Sommema4/Nicoll_GT/GME_nákup.pdf

Určení | Kód | Množství Cena za kus | Cena
GPTS203211B | 630-028 | 1 | 12 | 12
1N4007 | 220-002 popřpadě 917-065 | 5 | 1.6 | 8
1N5819 | 223-001 | 5 | 2.8 | 14
Barrel_Jack | 806-312 | 2 | 6.3 | 12.6
HE721A0510 | 634-012 | 2 | 27 | 54
BC547 | 210-026 | 5 | 1.7 | 8.5
1M | 901-036 | 5 | 0.68 | 3.4
10k | 901-003 | 10 | 0.68 | 6.8
1k | 901-029 | 5 | 0.68 | 3.4
2k | 901-066 | 5 | 0.68 | 3.4
5k | 901-128 | 5 | 0.68 | 3.4
470k | 901-110 | 5 | 0.68 | 3.4
Adaptér 9V | 751-811 | 1 | 139 | 139
Akumulátor | 540-492 | 1 | 159 | 159
Držák baterie 9V | 819-117 | 2 | 12 | 24
Napájecí konektor 9V 819-089 | 2 | 6.6 | 13.2
Patice PDIP-8 | 823-011 | 5 | 1.7 | 8.5
| | | | 476.6
