Sommema4/Nicoll_GT/Gerdien_tube_calculations.xlsx

Sheet: List1
Required properties |  |  | Comments | Constants
Min. sensitivity [ions/cm3] | 5 |  |  | 1 Coulomb [e-] | 1.602e+19
Temporal resolution [s] | 30
Fixed properties |  |  |  | Aux. calculations
ADC resolution [bits] | 12 |  | LoPy 4.0 | Min. detectable voltage [V] | 0.0029296875
Op-amp range [V] | 12 |  |  | SNR [-] | 3
Op-amp bias current [fA] | 5 |  |  | Min. ion current negative [fA] | 20
Outter electrode diameter [mm] | 15 |  |  | Min. ion current positive [fA] | 10
Inner electrode diameter [mm] | 3 |  |  | Min. negative ions charge [pC] | 0.6
Length of inner electrode [mm] | 150 |  |  | Min. positive ions charge [pC] | 0.3
 |  |  |  | Max. bias charge [pC] | 0.15
Computed properties
Capacity [pF] | 2
Flow [cm3/s] | 32040
Flow [m3/h] | 115.34
Flow [CFM] | 67.89 |  | https://cz.mouser.com/datasheet/2/471/San_Ace_60GV38_E-1286225.pdf
UAV speed [m/s] | 47.24
VD - dissipation [V][bits] | 0.075 | 25.6
VD - negative ion [V][bits] | 0.3 | 102.4
VD - positive ion [V][bits] | 0.15 | 51.2
Estimated fan power [W] | 23.76112032
dust sensor | sn-gcja5

Sheet: Sheet1
Year | Value |  | Divident value |  | Annual deposit | Budget | Divident
0 | 400000 | 0 | 16000 |  | 60000 | 400000 | 0.04 | 1000
1 | 476000 | 60000 | 19040 |  |  |  |  | 1030
2 | 555040 | 60000 | 22201.6 |  |  |  |  | 1060.9
3 | 637241.6 | 60000 | 25489.664 |  |  |  |  | 1092.727
4 | 722731.264 | 60000 | 28909.25056 |  |  |  |  | 1125.50881
5 | 811640.5146 | 60000 | 32465.62058 |  |  |  |  | 1159.274074
6 | 904106.1351 | 60000 | 36164.24541 |  |  |  |  | 1194.052297
7 | 1000270.381 | 60000 | 40010.81522 |  |  |  |  | 1229.873865
8 | 1100281.196 | 60000 | 44011.24783 |  |  |  |  | 1266.770081
9 | 1204292.444 | 60000 | 48171.69774 |  |  |  |  | 1304.773184
10 | 1312464.141 | 60000 | 52498.56565 |  |  |  |  | 1343.916379
11 | 1424962.707 | 60000 | 56998.50828 |  |  |  |  | 1384.233871
12 | 1541961.215 | 60000 | 61678.44861 |  |  |  |  | 1425.760887
13 | 1663639.664 | 60000 | 66545.58656 |  |  |  |  | 1468.533713
14 | 1790185.25 | 60000 | 71607.41002 |  |  |  |  | 1512.589725
15 | 1921792.66 | 60000 | 76871.70642 |  |  |  |  | 1557.967417
16 | 2058664.367 | 60000 | 82346.57468 |  |  |  |  | 1604.706439
17 | 2201010.942 | 60000 | 88040.43766 |  |  |  |  | 1652.847632
18 | 2349051.379 | 60000 | 93962.05517 |  |  |  |  | 1702.433061
19 | 2503013.434 | 60000 | 100120.5374 |  |  |  |  | 1753.506053
20 | 2663133.972 | 60000 | 106525.3589 | Added value |  |  |  | 1806.111235
 |  | 1200000 | 1169659.331 | 1063133.972
 |  | 0.6007959107 | 0.3992040893
