Sommema4/Nicoll_GT/Gerdien_tube.xlsx

Sheet: Gerdien_tube
Určovatel | Pouzdro | Množství | Určení | Dostupné | Cena za kus | Cena
S1 | PushButton_Round_D12mm_THT_KS-01Q-01 | 1 | GPTS203211B | 630-028 | 12 | 12
MH1,MH2,MH3,MH4 | MountingHole_3.2mm_M3_Pad | 4 | MountingHole_Pad |  |  | 0
A1 | Arduino_Nano | 1 | Arduino_Nano_v3.x |  |  | 0
C1,C3,C4,C6,C8 | C_1206_3216Metric_Pad1.42x1.75mm_HandSolder | 5 | 10uF | https://cz.mouser.com/ProductDetail/KEMET/C1206C106K4PACTU?qs=nz7vn1PXJ%2Feyzlyip0aTxw%3D%3D | 5.62 | 28.1
C2,C7,C10,C11 | C_0805_2012Metric_Pad1.15x1.40mm_HandSolder | 4 | 1uF | https://cz.mouser.com/ProductDetail/Taiyo-Yuden/EMK212B7105KG-T?qs=I6KAKw0tg2yMLHYVqC1Cbg%3D%3D | 3.04 | 12.16
C5 | C_0805_2012Metric_Pad1.15x1.40mm_HandSolder | 1 | 0.1uF | https://cz.mouser.com/ProductDetail/Wurth-Elektronik/885012207045?qs=0KOYDY2FL2%252BXQfJ0lEk3cQ%3D%3D | 2.08 | 2.08
C9 | C_1206_3216Metric_Pad1.42x1.75mm_HandSolder | 1 | 22uF | https://cz.mouser.com/ProductDetail/Taiyo-Yuden/EMK316ABJ226KL-T?qs=vRDgv%252B14ozAnLVgeVXAjKA%3D%3D | 11.7 | 11.7
D1,D3 | D_DO-41_SOD81_P10.16mm_Horizontal | 2 | 1N4007 | 220-002 popřpadě 917-065 | 1.6 | 3.2
D2 | D_DO-41_SOD81_P10.16mm_Horizontal | 1 | 1N5819 | 223-001 | 2.8 | 2.8
IC1 | SOIC127P600X175-8N | 1 | LMC6042IN/NOPB | https://cz.mouser.com/ProductDetail/Texas-Instruments/LMC6042IN-NOPB?qs=QbsRYf82W3F%252BvJ4QFsi9pA%3D%3D | 79.82 | 79.82
IC2 | SOP65P490X110-8N | 1 | CAT5140ZI-00-GT3 | https://cz.mouser.com/ProductDetail/ON-Semiconductor/CAT5140ZI-00-GT3 | 55.64 | 55.64
J1 | PinSocket_2x08_P2.54mm_Vertical | 1 | Conn_02x08_Odd_Even |  |  | 0
J2,J3 | PinSocket_1x06_P2.54mm_Vertical | 2 | Conn_01x06_Female |  |  | 0
J4 | PinHeader_1x03_P2.54mm_Vertical | 1 | Conn_01x03_Male |  |  | 0
J6,J7 | PinSocket_1x01_P2.54mm_Vertical | 2 | Conn_01x01_Female |  |  | 0
J8 | BarrelJack_Horizontal | 1 | Barrel_Jack | 806-312 | 6.3 | 6.3
J9,J10 | PinHeader_1x02_P2.54mm_Horizontal | 2 | Conn_01x02_Male |  |  | 0
K1,K2 | HE721A0510 | 2 | HE721A0510 | 634-012 | 27 | 54
MH5,MH6,MH7 | MountingHole_2.5mm | 3 | MountingHole |  |  | 0
PS1,PS2 | RP0512D | 2 | RH-0515D | https://cz.mouser.com/ProductDetail/RECOM-Power/RH-0515D?qs=YWgezujkI1I0O2RytZapjw%3D%3D | 171.34 | 342.68
Q1 | SOT-23-3 | 1 | BSS138 | https://cz.mouser.com/ProductDetail/ON-Semiconductor-Fairchild/BSS138?qs=HK%252BeIG1iaahCeqBvjB4arg%3D%3D | 6.08 | 6.08
Q2,Q5 | TO-92_Inline | 2 | BC547 | 210-026 | 1.7 | 3.4
Q3 | SOT95P237X112-3N | 1 | FDN306P | https://cz.mouser.com/ProductDetail/ON-Semiconductor-Fairchild/FDN306P | 10.53 | 10.53
Q4 | SOT-23-6 | 1 | LTC4412ES6_TRMPBF | https://cz.mouser.com/ProductDetail/Analog-Devices-Linear-Technology/LTC4412ES6TRMPBF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 | 80.6 | 80.6
R1,R3 | R_0805_2012Metric_Pad1.15x1.40mm_HandSolder | 2 | 1M | 901-036 | 0.68 | 1.36
R2,R4,R6,R13,R14 | R_0805_2012Metric_Pad1.15x1.40mm_HandSolder | 5 | 10k | 901-003 | 0.68 | 3.4
R5,R9,R16 | R_0805_2012Metric_Pad1.15x1.40mm_HandSolder | 3 | 1k | 901-029 | 0.68 | 2.04
R10 | R_0805_2012Metric_Pad1.15x1.40mm_HandSolder | 1 | 2k | 901-066 | 0.68 | 0.68
R11,R12 | R_0805_2012Metric_Pad1.15x1.40mm_HandSolder | 2 | 5k | 901-128 | 0.68 | 1.36
TP1,TP2 | PinHeader_1x01_P2.54mm_Vertical | 2 | TestPoint |  |  | 0
U1 | TEC3_0911 | 1 | TEC_3-0911 | https://cz.mouser.com/ProductDetail/TRACO-Power/TEC-3-0911?qs=55YtniHzbhAODAHTZEB25A%3D%3D | 281.32 | 281.32
G*** | CRREAT_197x129 | 1 | LOGO |  |  | 0
J11 | PinHeader_1x02_P2.54mm_Vertical | 1 | Conn_01x02_Male |  |  | 0
J5 | TerminalBlock_RND_205-00278_1x04_P5.00mm_Vertical | 1 | Screw_Terminal_01x04 |  |  | 0
R15 | R_0805_2012Metric_Pad1.15x1.40mm_HandSolder | 1 | 470k | 901-110 | 0.68 | 0.68
 | Adaptér | 1 |  | 751-811 | 139 | 139
 | Akumulátor | 1 |  | 540-492 | 159 | 159
 | Držák baterie | 1 |  | 819-117 | 12 | 12
 | Držák baterie | 1 |  | 819-089 | 6.6 | 6.6
 | patice | 1 |  | 823-011 | 1.7 | 1.7
 |  |  |  |  |  | 1320.23

Sheet: GME
Určení | Kód | Množství | Cena za kus | Cena
GPTS203211B | 630-028 | 1 | 12 | 12
1N4007 | 220-002 popřpadě 917-065 | 5 | 1.6 | 8
1N5819 | 223-001 | 5 | 2.8 | 14
Barrel_Jack | 806-312 | 2 | 6.3 | 12.6
HE721A0510 | 634-012 | 2 | 27 | 54
BC547 | 210-026 | 5 | 1.7 | 8.5
1M | 901-036 | 5 | 0.68 | 3.4
10k | 901-003 | 10 | 0.68 | 6.8
1k | 901-029 | 5 | 0.68 | 3.4
2k | 901-066 | 5 | 0.68 | 3.4
5k | 901-128 | 5 | 0.68 | 3.4
470k | 901-110 | 5 | 0.68 | 3.4
Adaptér 9V | 751-811 | 1 | 139 | 139
Akumulátor | 540-492 | 1 | 159 | 159
Držák baterie 9V | 819-117 | 2 | 12 | 24
Napájecí konektor 9V | 819-089 | 2 | 6.6 | 13.2
Patice PDIP-8 | 823-011 | 5 | 1.7 | 8.5
 |  |  |  | 476.6
