Sommema4/Nicoll_GT/Gerdien_tube.pdf

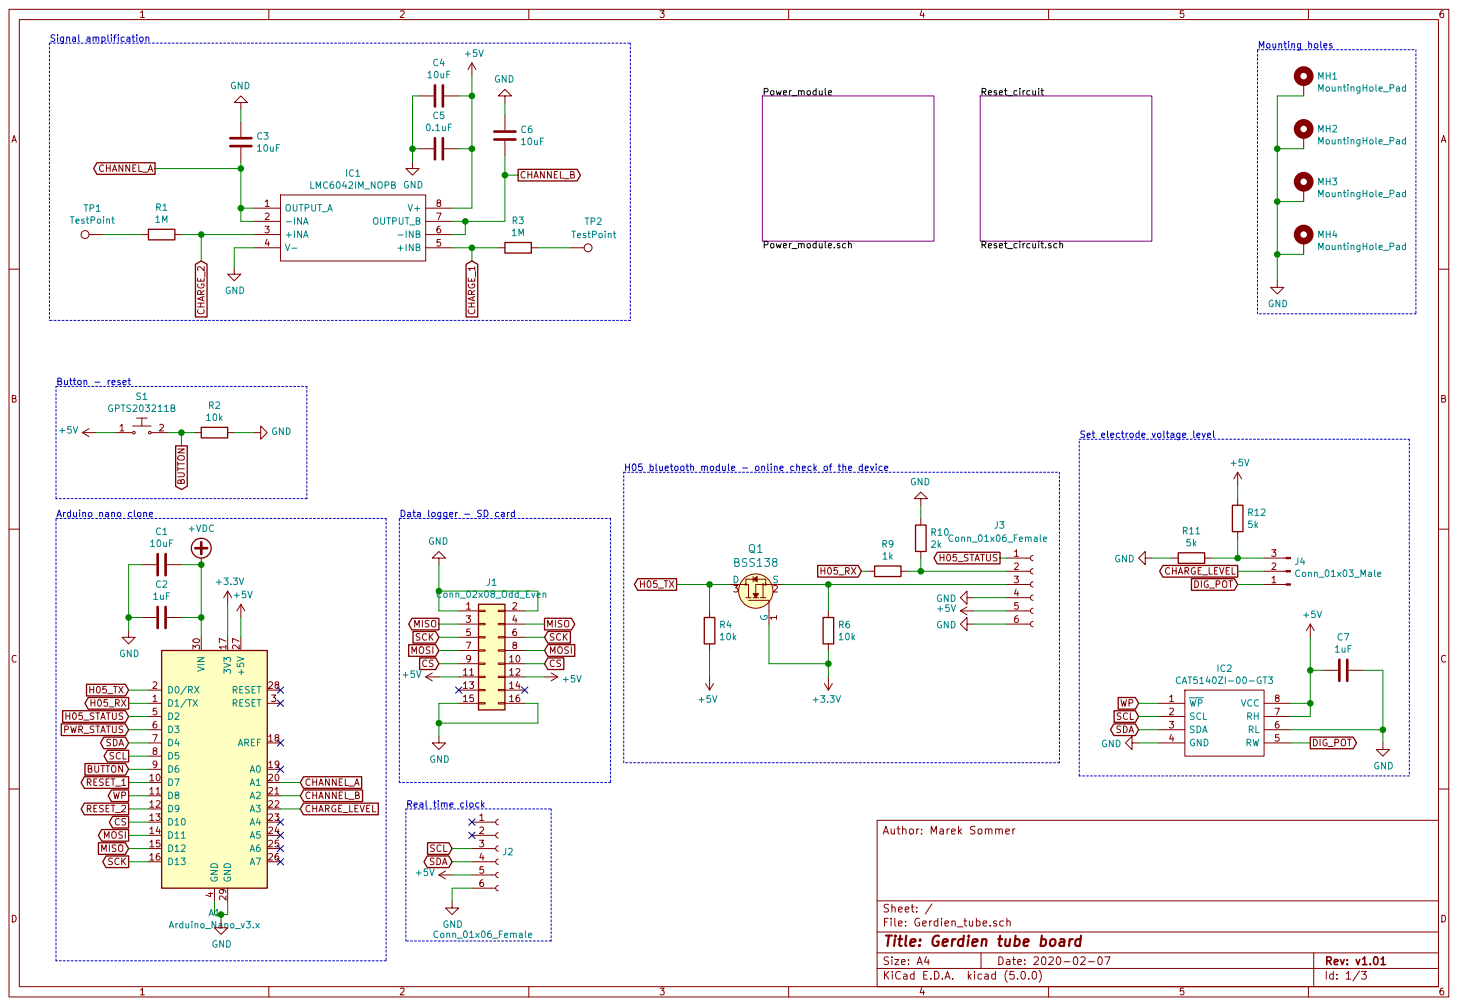
[picture p1: page 1]

SCL Arduino nano clone RESET_1

10k +5V H05 bluetooth module - online check of the device WP

Data logger - SD card

SCL Real time clock CHANNEL_A CHANNEL_B

File: Gerdien_tube.sch Sheet: / Author: Marek Sommer

Id: 1/3 Title: Gerdien tube board

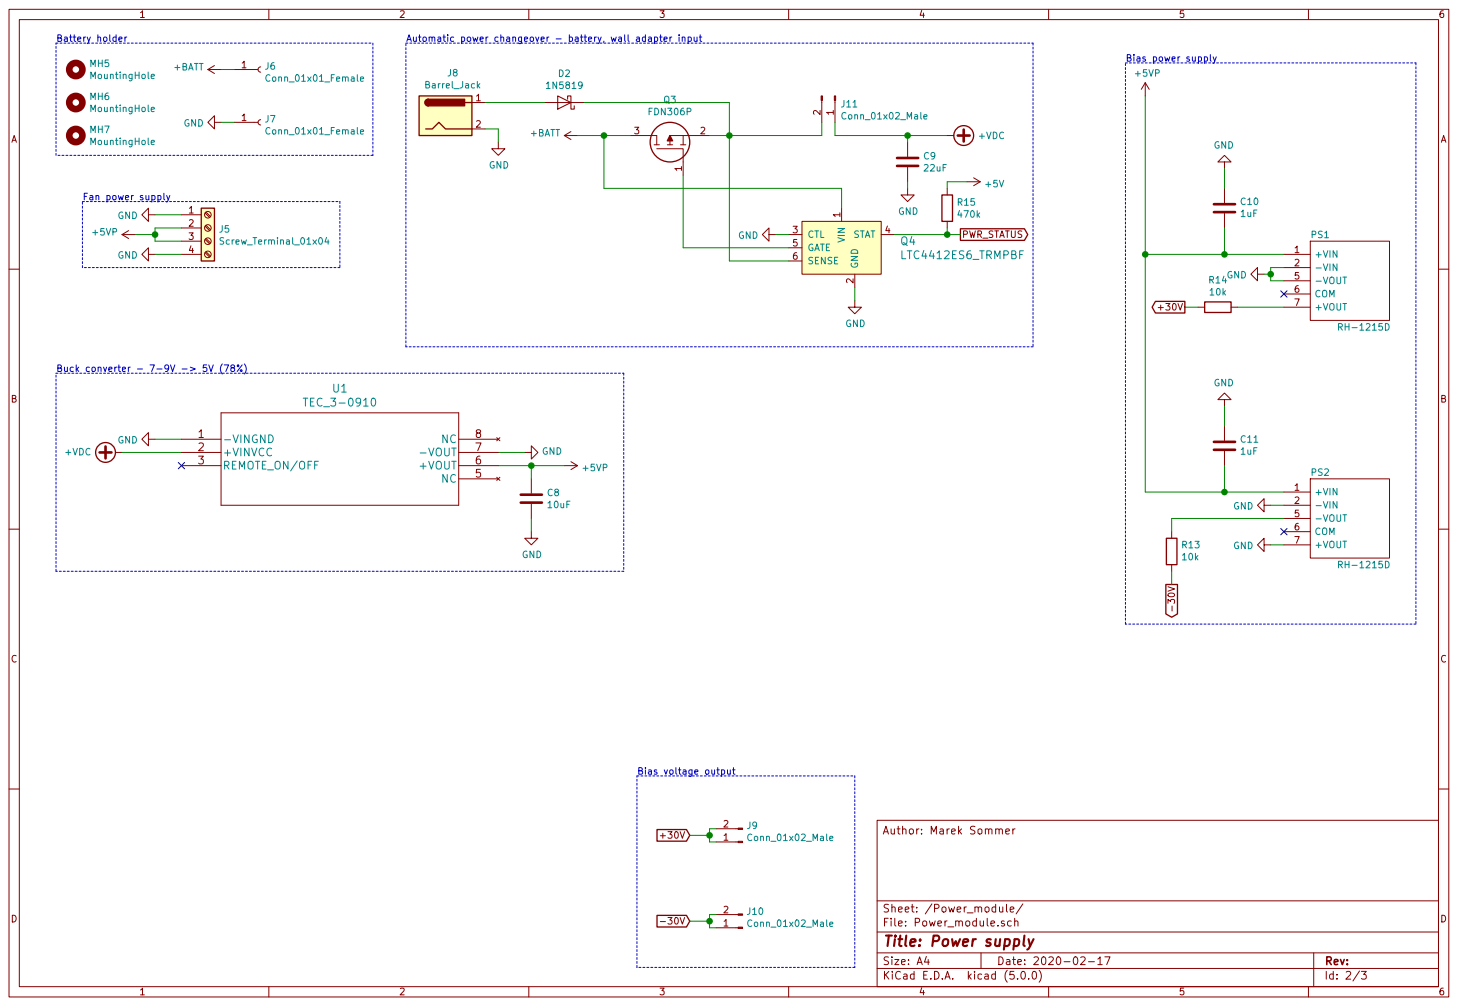
[picture p2: page 2]

2 CTL 3 STAT 4 GATE 5 SENSE 6 Q4

Sheet: /Power_module/ Author: Marek Sommer

File: Power_module.sch
Id: 2/3 Title: Power supply

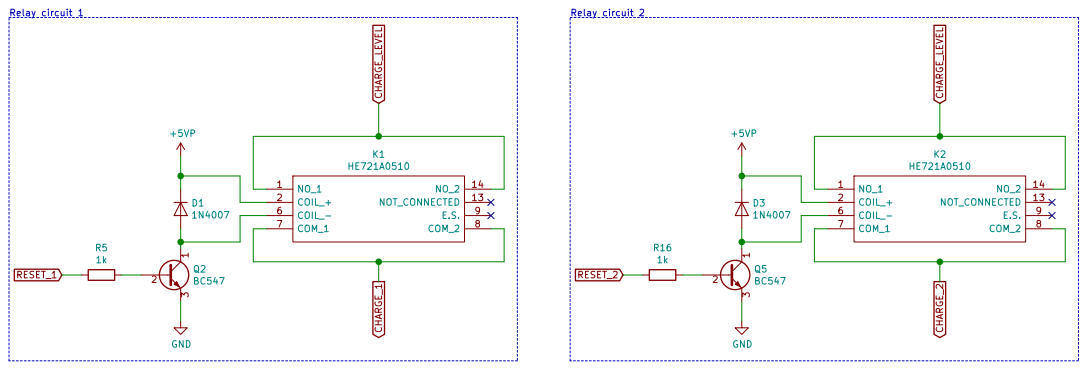
[picture p3: page 3]
