Sommema4/Nicoll_GT/Gerdien_tube.kicad_pcb

## KiCad design Gerdien_tube.kicad_pcb (2020-08-20)

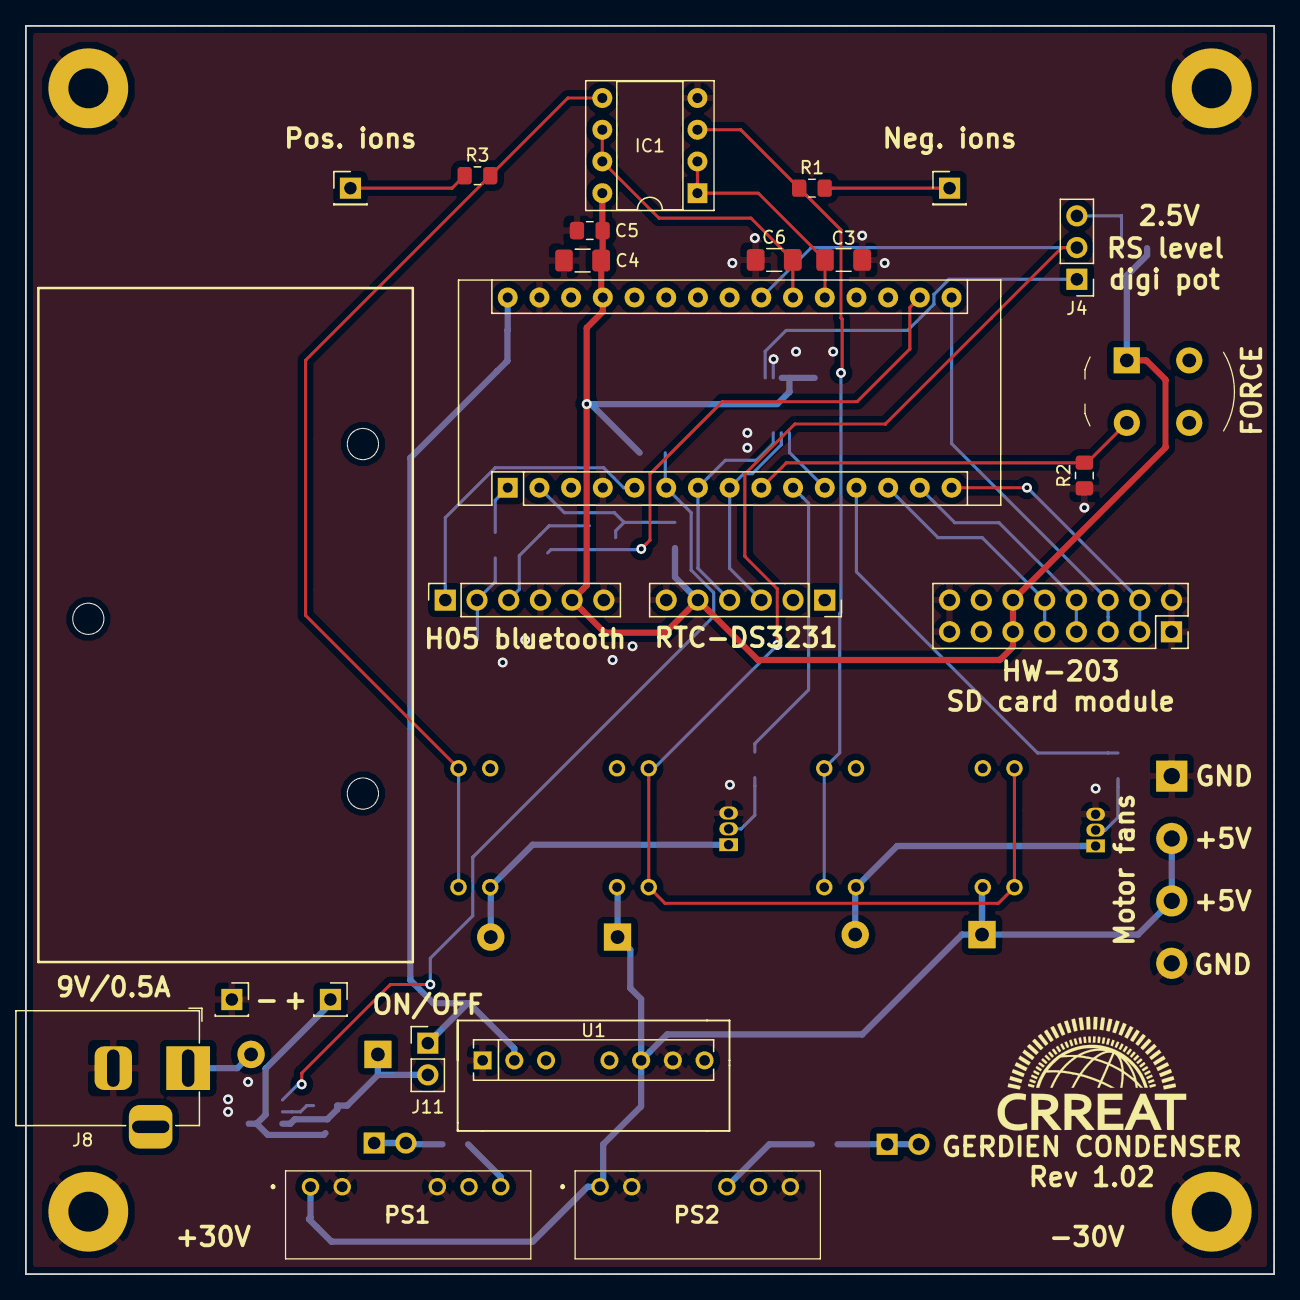
[picture p4: board Gerdien_tube.kicad_pcb from above]

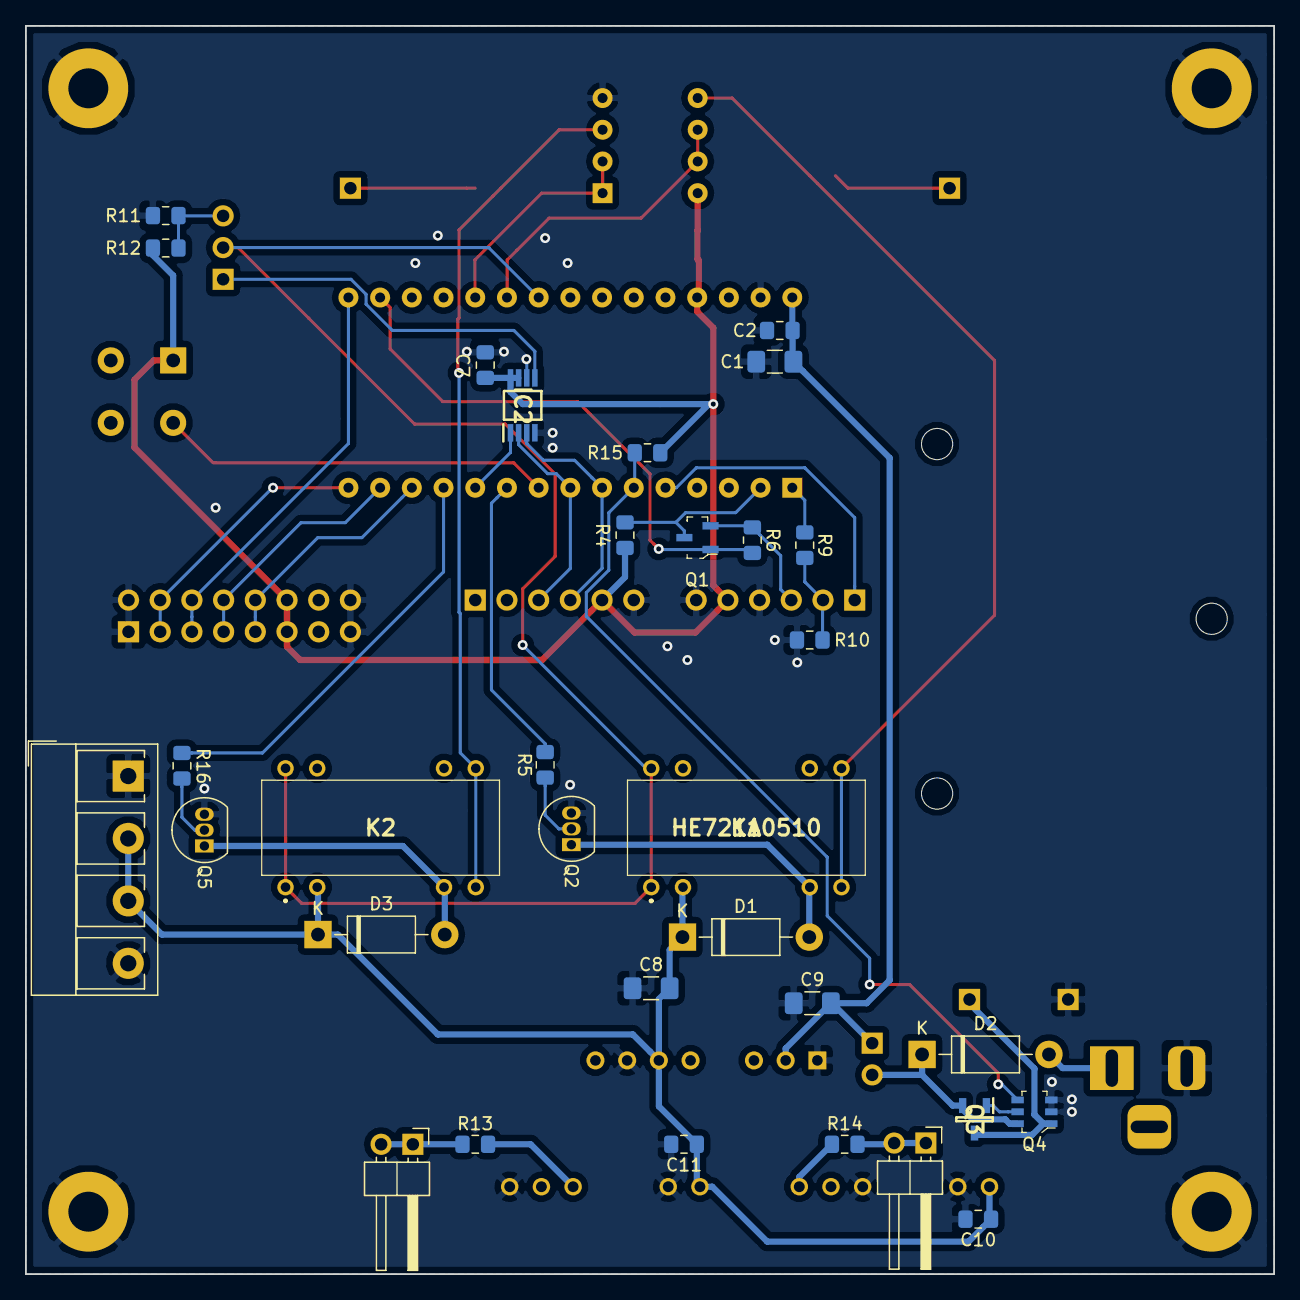
[picture p5: board Gerdien_tube.kicad_pcb from below]

Board: 2 copper layers, 100.0 x 100.0 mm, 62 parts (32 on the bottom side), 42 nets.

Parts:
A1: Arduino_Nano_v3.x; Arduino_Nano
C1, C3, C4, C6, C8: 10uF; C_1206_3216Metric_Pad1.42x1.75mm_HandSolder
C2, C7, C10, C11: 1uF; C_0805_2012Metric_Pad1.15x1.40mm_HandSolder
C5: 0.1uF; C_0805_2012Metric_Pad1.15x1.40mm_HandSolder
C9: 22uF; C_1206_3216Metric_Pad1.42x1.75mm_HandSolder
D1, D3: 1N4007; D_DO-41_SOD81_P10.16mm_Horizontal
D2: 1N5819; D_DO-41_SOD81_P10.16mm_Horizontal
IC1: LMC6042IM_NOPB; DIP-8_W7.62mm_Socket
IC2: CAT5140ZI-00-GT3; SOP65P490X110-8N
J1: Conn_02x08_Odd_Even; PinSocket_2x08_P2.54mm_Vertical
J2, J3: Conn_01x06_Female; PinSocket_1x06_P2.54mm_Vertical
J4: Conn_01x03_Male; PinHeader_1x03_P2.54mm_Vertical
J5: Screw_Terminal_01x04; TerminalBlock_RND_205-00278_1x04_P5.00mm_Vertical
J6, J7: Conn_01x01_Female; PinSocket_1x01_P2.54mm_Vertical
J8: Barrel_Jack; BarrelJack_Horizontal
J9, J10: Conn_01x02_Male; PinHeader_1x02_P2.54mm_Horizontal
J11: Conn_01x02_Male; PinHeader_1x02_P2.54mm_Vertical
K1, K2: HE721A0510
MH1, MH2, MH3, MH4: MountingHole_Pad; MountingHole_3.2mm_M3_Pad
MH5, MH6, MH7: MountingHole; MountingHole_2.5mm
PS1, PS2: RH-1215D; RP1212D
Q1: BSS138; SOT-23-3
Q2, Q5: BC547; TO-92_Inline
Q3: FDN306P; SOT95P237X112-3N
Q4: LTC4412ES6_TRMPBF; SOT-23-6
R1, R3: 1M; R_0805_2012Metric_Pad1.15x1.40mm_HandSolder
R2, R4, R6, R13, R14: 10k; R_0805_2012Metric_Pad1.15x1.40mm_HandSolder
R5, R9, R16: 1k; R_0805_2012Metric_Pad1.15x1.40mm_HandSolder
R10: 2k; R_0805_2012Metric_Pad1.15x1.40mm_HandSolder
R11, R12: 5k; R_0805_2012Metric_Pad1.15x1.40mm_HandSolder
R15: 470k; R_0805_2012Metric_Pad1.15x1.40mm_HandSolder
S1: GPTS203211B; PushButton_Round_D12mm_THT_KS-01Q-01
TP1, TP2: TestPoint; PinHeader_1x01_P2.54mm_Vertical
U1: TEC_3-0910; TEC3_0911

Connections:
+3V3: A1.17, Q1.1, R6.2
+5V: A1.27, C4.1, C5.1, C7.2, IC1.8, IC2.7, IC2.8, J1.11, J1.12, J2.5, J3.5, R4.2, R12.1, R15.1, S1.1
+5VP: C8.1, C10.1, C11.1, D1.1, D3.1, J5.2, J5.3, K1.2, K2.2, PS1.1, PS2.1, U1.6
+30V: J9.1, J9.2, R14.2
+BATT: J6.1, Q3.3, Q4.1
+VDC: A1.30, C1.1, C2.1, C9.1, J11.1, U1.2
-30V: J10.1, J10.2, R13.1
BUTTON: A1.9, R2.2, S1.2
CHANNEL_A: A1.20, C3.2, IC1.1, IC1.2
CHANNEL_B: A1.21, C6.2, IC1.6, IC1.7
CHARGE_1: IC1.5, K1.7, K1.8, R3.2
CHARGE_2: IC1.3, K2.7, K2.8, R1.1
CHARGE_LEVEL: A1.22, J4.2, K1.1, K1.14, K2.1, K2.14
CS: A1.13, J1.9, J1.10
DIG_POT: IC2.5, J4.1
GND: A1.4, A1.29, C1.2, C2.2, C3.1, C4.2, C5.2, C6.1, C7.1, C8.2, C9.2, C10.2, C11.2, IC1.4, IC2.4, IC2.6, J1.1, J1.2, J1.15, J1.16, J2.6, J3.4, J3.6, J5.1, J5.4, J7.1, J8.2, MH1.1, MH2.1, MH3.1, MH4.1, PS1.2, PS1.5, PS2.2, PS2.7, Q2.3, Q4.2, Q4.3, Q5.3, R2.1, R10.1, R11.2, U1.1, U1.7
H05_RX: A1.1, R9.2
H05_STATUS: A1.5, J3.1
H05_TX: A1.2, Q1.3, R4.1
MISO: A1.15, J1.3, J1.4
MOSI: A1.14, J1.7, J1.8
unnamed: D1.2, K1.6, Q2.1
unnamed: D2.1, J11.2, Q3.2, Q4.6
unnamed: D2.2, J8.1
unnamed: D3.2, K2.6, Q5.1
unnamed: J3.2, R9.1, R10.2
unnamed: J3.3, Q1.2, R6.1
unnamed: J4.3, R11.1, R12.2
unnamed: PS1.7, R14.1
unnamed: PS2.5, R13.2
unnamed: Q2.2, R5.1
unnamed: Q3.1, Q4.5
unnamed: Q5.2, R16.1
unnamed: R1.2, TP1.1
unnamed: R3.1, TP2.1
PWR_STATUS: A1.6, Q4.4, R15.2
RESET_1: A1.10, R5.2
RESET_2: A1.12, R16.2
SCK: A1.16, J1.5, J1.6
SCL: A1.8, IC2.2, J2.3
SDA: A1.7, IC2.3, J2.4
WP: A1.11, IC2.1
